stortoaranci/Jabby/images/img_5.jpg

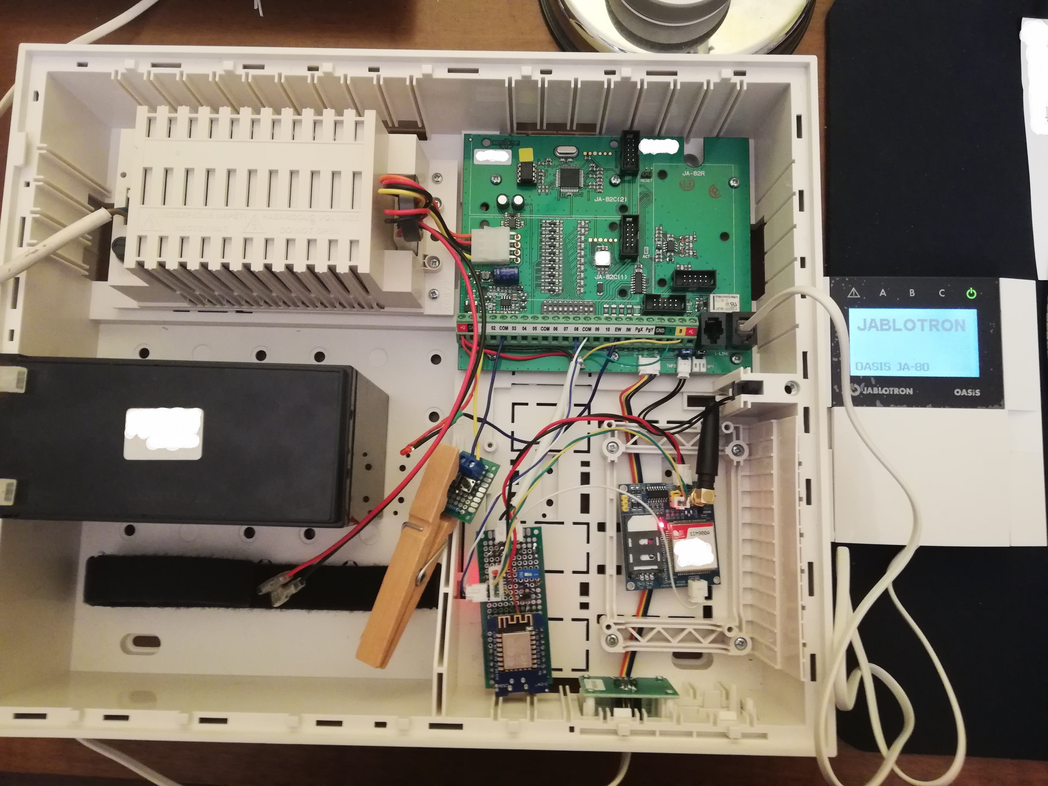
images/img_5.jpg
