stortoaranci/Jabby/images/img_1.jpg

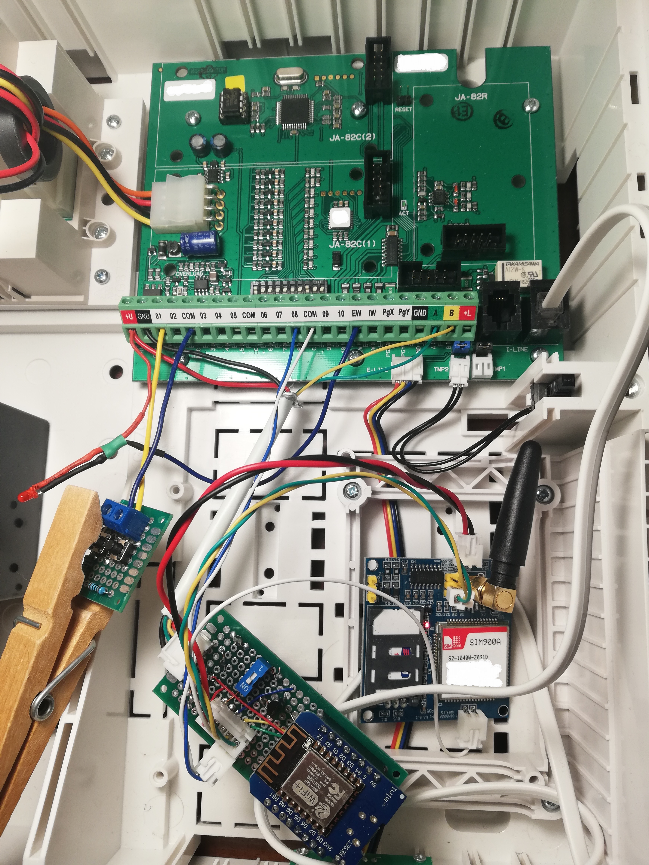
images/img_1.jpg
