stortoaranci/Jabby/images/HomeAssistant_Triggered.jpg

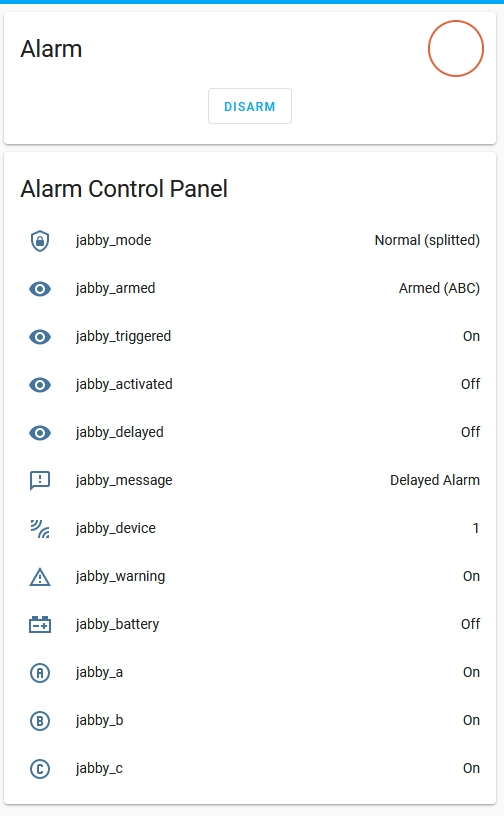
images/HomeAssistant_Triggered.jpg
