stortoaranci/Jabby/images/img_2.jpg

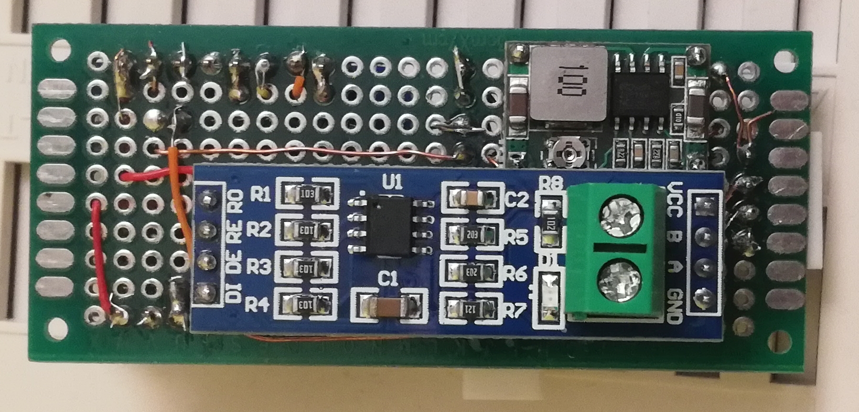
images/img_2.jpg
