stortoaranci/Jabby/images/img_3.jpg

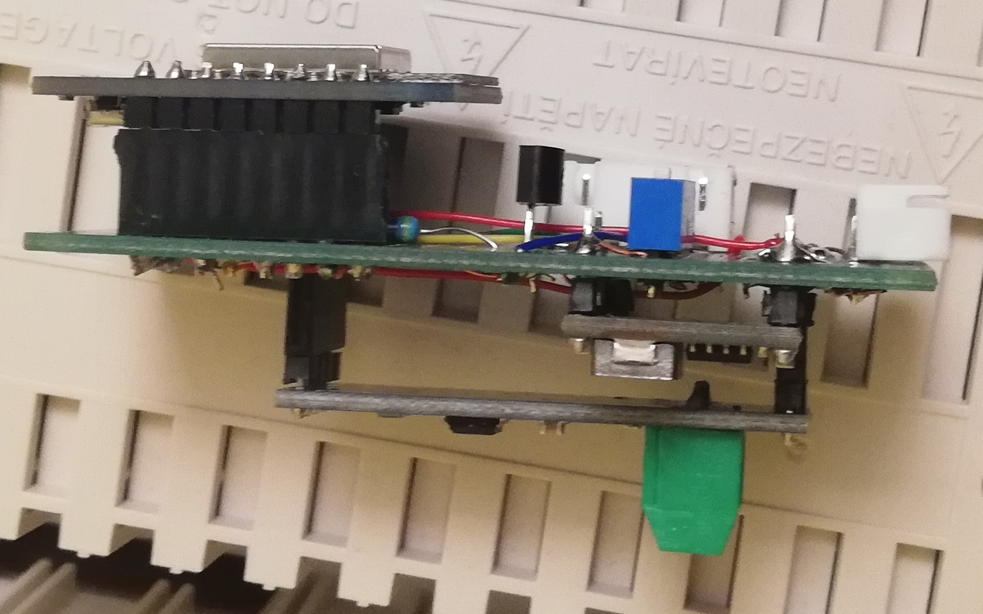
images/img_3.jpg
