stortoaranci/Jabby/images/img_4.jpg

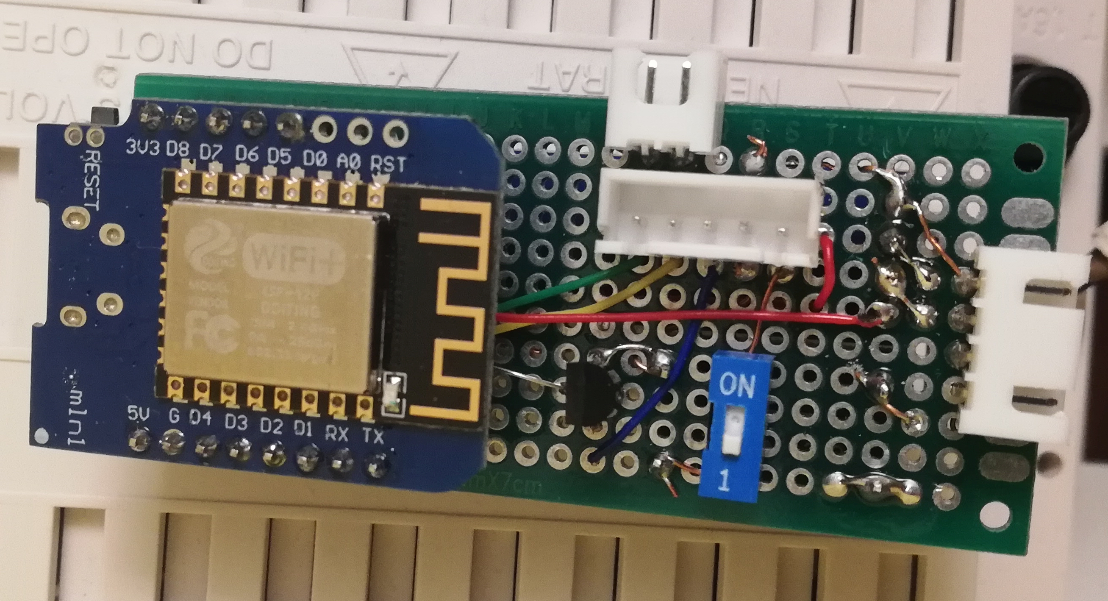
images/img_4.jpg
