stortoaranci/Jabby/docs/schematic.pdf

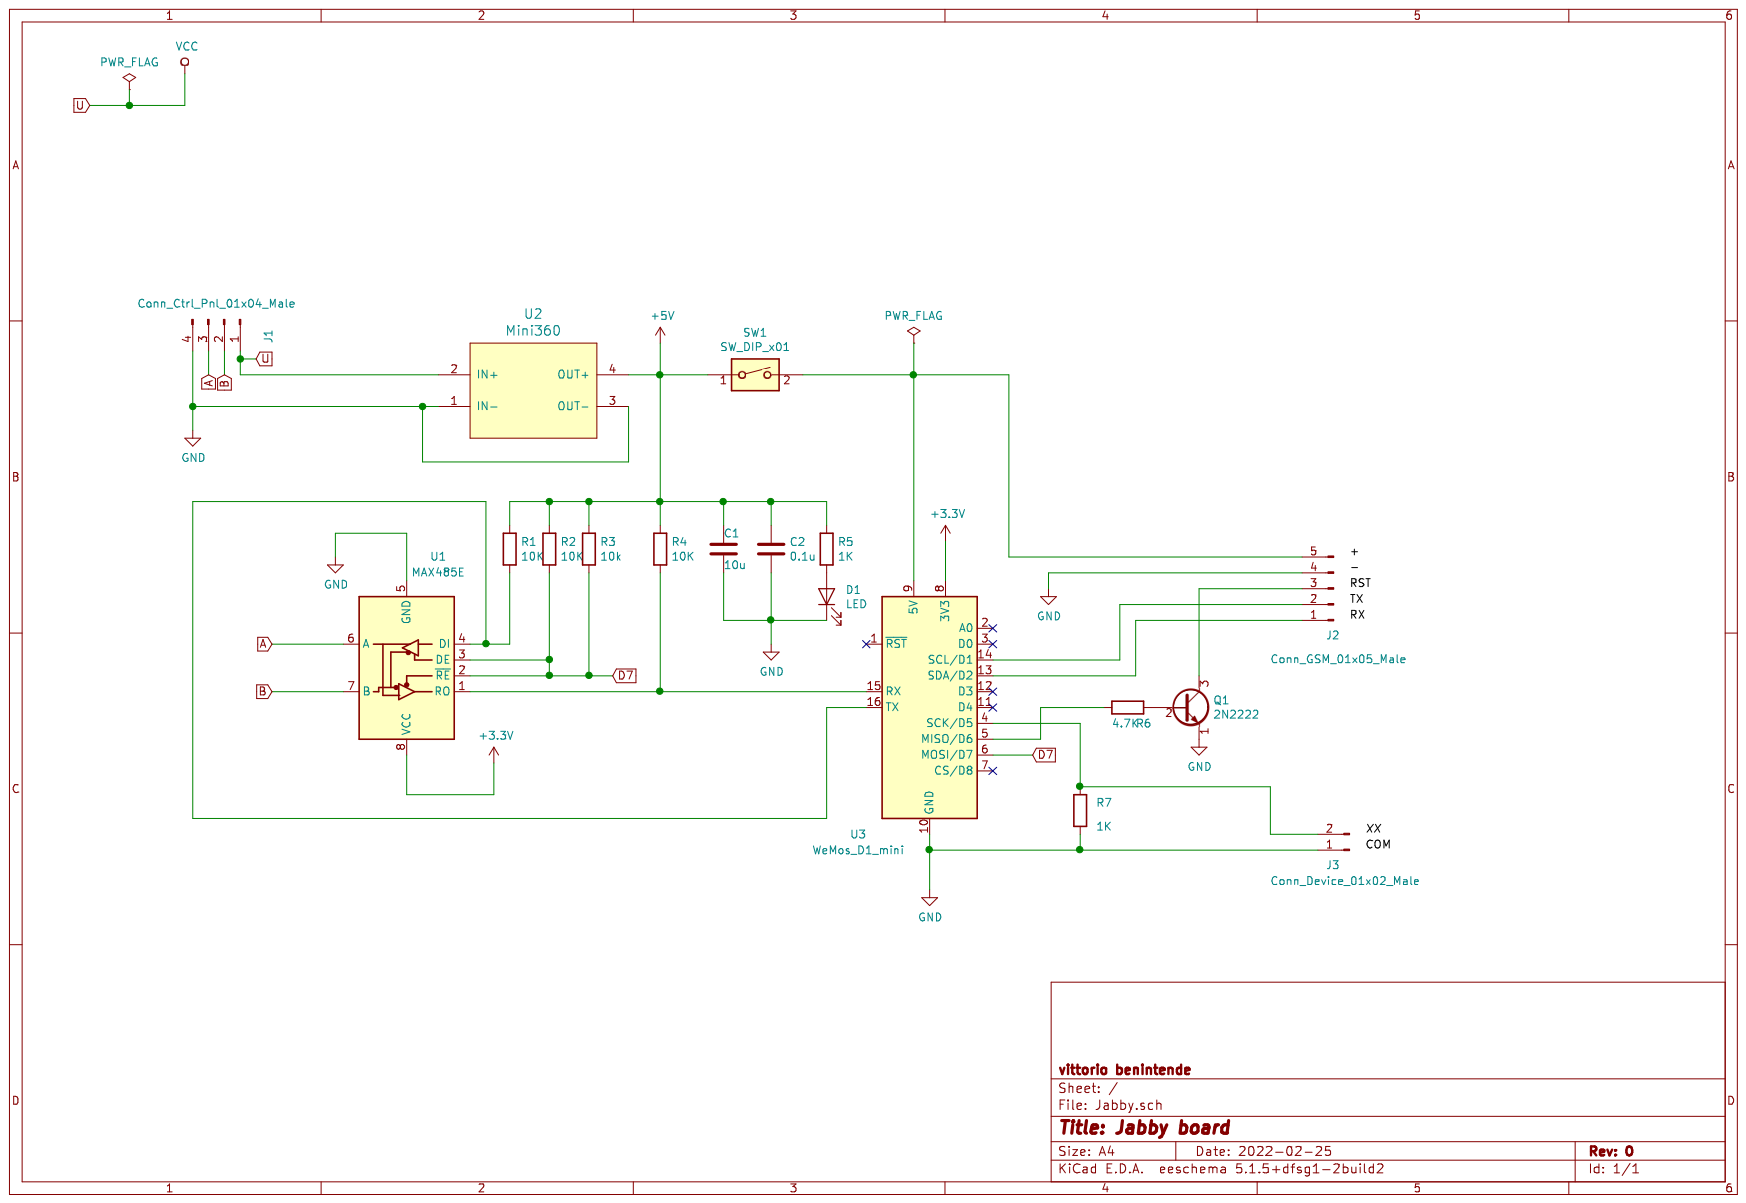
[picture p7: page 1]
