stortoaranci/Jabby/kicad/Jabby.sch

## KiCad design kicad/Jabby.sch (2022-05-04, an earlier design)

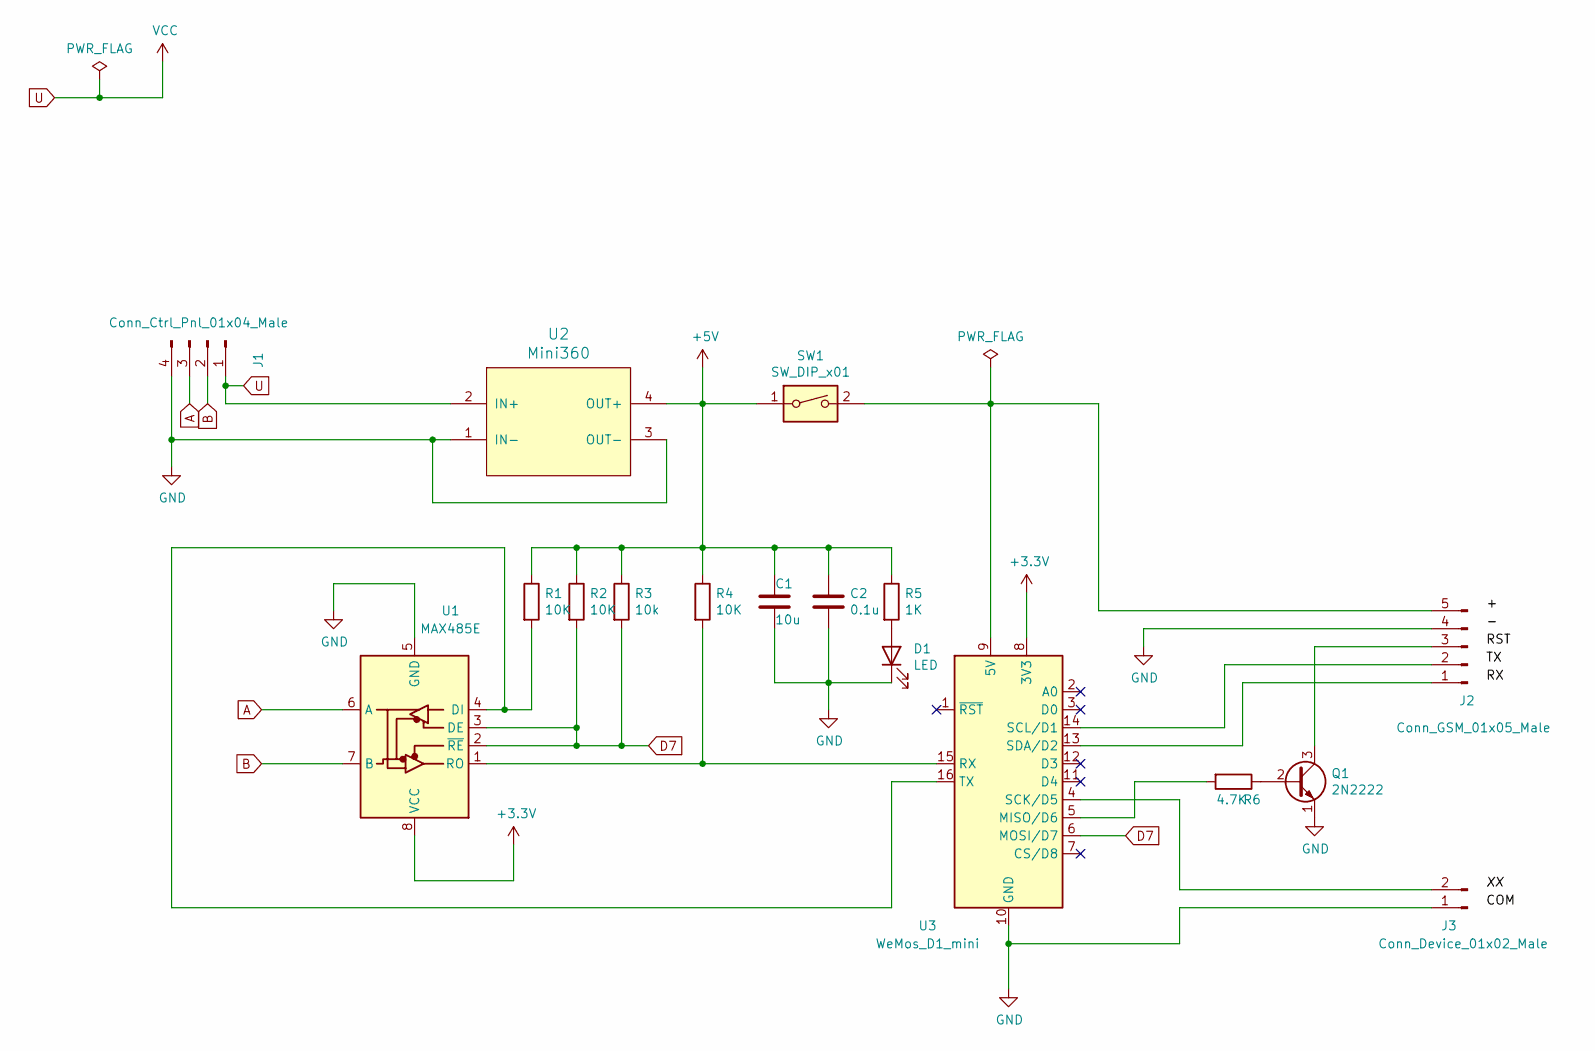
[picture p8: schematic Jabby.sch]

Parts:
C1: 10u
C2: 0.1u
D1: LED
J1: Conn_Ctrl_Pnl_01x04_Male
J2: Conn_GSM_01x05_Male
J3: Conn_Device_01x02_Male
Q1: 2N2222; TO-39-3
R1, R2, R4: 10K
R3: 10k
R5: 1K
R6: 4.7K
SW1: SW_DIP_x01
U1: MAX485E
U2: Mini360
U3: WeMos_D1_mini; WEMOS_D1_mini_light

Connections:
+3.3V: U1.8 (VCC), U3.8 (3V3)
+5V: C1.1, C2.1, R1.1, R2.1, R3.1, R4.1, R5.1, SW1.1, U2.4 (OUT+)
A: J1.3, U1.6 (A)
B: J1.2, U1.7 (B)
D7: R2.2, R3.2, U1.2 (~RE), U1.3 (DE), U3.6 (MOSI/D7)
GND: C1.2, C2.2, D1.1 (K), J1.4, J2.4, J3.1, Q1.1 (E), U1.5 (GND), U2.1 (IN-), U2.3 (OUT-), U3.10 (GND)
unnamed: D1.2 (A), R5.2
unnamed: J2.1, U3.13 (SDA/D2)
unnamed: J2.2, U3.14 (SCL/D1)
unnamed: J2.3, Q1.3 (C)
unnamed: J2.5, SW1.2, U3.9 (5V)
unnamed: J3.2, U3.4 (SCK/D5)
unnamed: Q1.2 (B), R6.1
unnamed: R1.2, U1.4 (DI), U3.16 (TX)
unnamed: R4.2, U1.1 (RO), U3.15 (RX)
unnamed: R6.2, U3.5 (MISO/D6)
U: J1.1, U2.2 (IN+)
