stortoaranci/Jabby/(commit log)

2022-03-03 device, battery, warning
2022-03-04 arm commands
2022-03-19 invia sms ma ancora errore rejected alla fine
    [Jabby_sketch.ino, config.h]
